parikshitpagare/parcel-tracking-rtos/website/assets/background-logistics.jpg

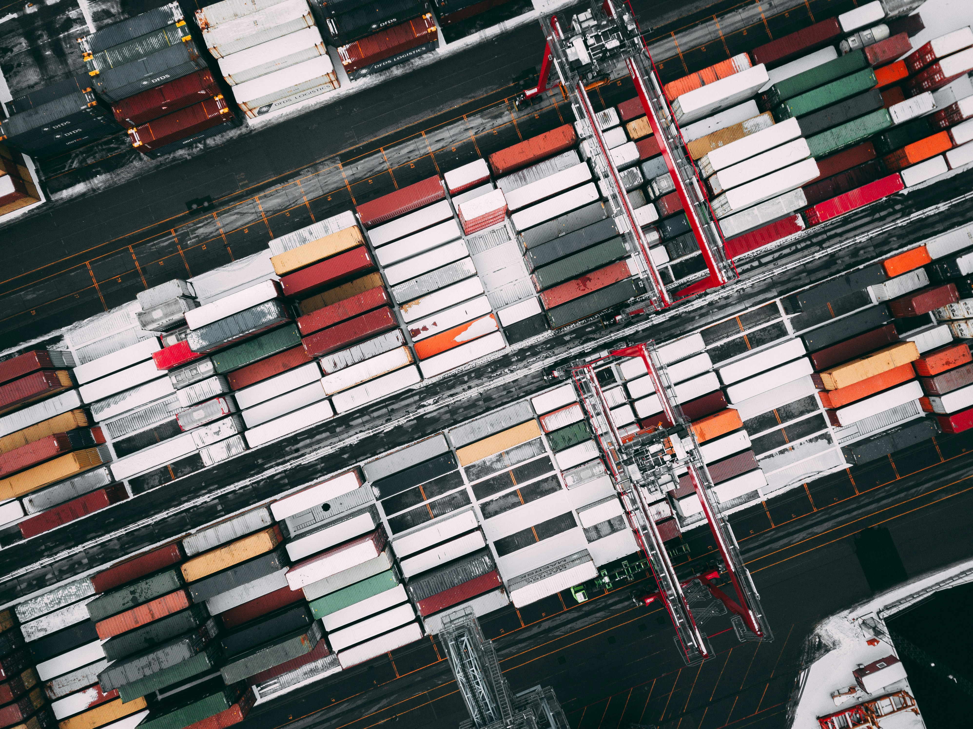
website/assets/background-logistics.jpg
