parikshitpagare/parcel-tracking-rtos/(commit log)

2024-01-04 added schematic
2024-01-04 updated esp32 code
