parikshitpagare/parcel-tracking-rtos/(notices)

Notices in the files:
README.md:
License: MIT
